wojtron2/HW_STM32H743_board_WFL/README.md

# HW_STM32H743_board_WFL
An STM32H743 KiCad project board
