wojtron2/HW_STM32H743_board_WFL/BOM/preBOM_stm32h743_board.txt

STM32H743
LQFP100

tu akurat dostępność słaba u różnych dostawców - jednak kluczowy element projektu
STM32H743VIT6
https://www.mouser.pl/pl/ProductDetail/STMicroelectronics/STM32H743VIT6?qs=FNcb6ahWXRw0Me5k2ZHgWw%3D%3D

jak wyżej - aktualnie słaba dostępność ale wymóg projektu

IMU Bosch BMI088
https://www.mouser.pl/pl/ProductDetail/Bosch-Sensortec/BMI088?qs=f9yNj16SXrIMFspTV6RB6Q%3D%3D

zasilanie DCDC SMPS
ultra low emi
LT8609SEV#PBF
https://www.mouser.pl/pl/ProductDetail/Analog-Devices/LT8609SEVPBF?qs=BZBei1rCqCCvvHT89A2j%2FQ%3D%3D

zasilanie LDO dla uC STM32H743
AP7361C-33E
https://www.mouser.pl/pl/ProductDetail/Diodes-Incorporated/AP7361C-33E-13?qs=X421pCAdHWeIInddOHvgmw%3D%3D

zasilanie dla IMU Bosch BMI088
-zastosowac wspolna linie zasilania z STM32H743 dodatkowo filtrowana-

dioda TVS zabezpieczajaca na wejsciu od strony baterii
SMBJ26A
https://www.tme.eu/pl/details/smbj26a-tr/diody-tvs-smd-jednokierunkowe/stmicroelectronics/

kwarc stm32h743
TSX-3225 16.0000MF18X-AC0
https://www.mouser.pl/pl/ProductDetail/Epson-Timing/TSX-3225-16.0000MF18X-AC0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

kond kwarca 10pF
https://www.tme.eu/pl/details/grm1555c1h100ga01d/kondensatory-mlcc-smd/murata/

bezpiecznik 1A
https://www.tme.eu/pl/details/0680l1000-05/bezpieczniki-smd-2410-zwloczne/bel-fuse/

ferryt dla vdda i BMI088
BLM21PG221SN1D
https://www.tme.eu/pl/details/blm21pg221sn1d/ferryty-koraliki/murata/

flash
W25Q512JVEIQ
https://www.mouser.pl/pl/ProductDetail/Winbond/W25Q512JVEIQ-TR?qs=l7cgNqFNU1jq8%252B28uQ9f7A%3D%3D

10pF 0402

10nF 0402 X7R
https://www.mouser.pl/pl/ProductDetail/Vishay-Vitramon/VJ0402Y103KXQCW1BC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

100nF 0402 X7R
https://www.mouser.pl/pl/ProductDetail/TAIYO-YUDEN/MSAST105SB7104MFNB25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

1uF 0603
https://www.mouser.pl/pl/ProductDetail/Walsin/SH18B105K160CT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

2.2uF 0603
https://www.mouser.pl/pl/ProductDetail/Murata-Electronics/GRM188Z71E225KE43D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

4.7uF 0603
https://www.mouser.pl/pl/ProductDetail/Samsung-Electro-Mechanics/CL10A475KO8NNNC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

47uF 1206
https://www.mouser.pl/pl/ProductDetail/TDK/C3216X5R1C476M160AB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

10k rez 0402

18.2k rez 0402

100k rez 0402

182k rez 0402

1M rez 0402

L1 2.2uH
TDK SPM3020T-2R2M-LR
https://www.mouser.pl/pl/ProductDetail/TDK/SPM3020T-2R2M-LR?qs=P8zzrVhehatRwwTBeABiag%3D%3D

EW mniejszy
TDK VLS252012HBX-2R2M-1

//////////////
zzzzzz old

LDL1117S33R
https://www.mouser.pl/pl/ProductDetail/STMicroelectronics/LDL1117S33R?qs=AQlKX63v8Rt9Bf6AWSrbFg%3D%3D

AP7361C-33E
https://www.mouser.pl/pl/ProductDetail/Diodes-Incorporated/AP7361C-33E-13?qs=X421pCAdHWeIInddOHvgmw%3D%3D

zold kwarc 16mhz
ABM10W-16.0000MHZ-6-D1X-T3
https://www.mouser.pl/pl/ProductDetail/ABRACON/ABM10W-16.0000MHZ-6-D1X-T3?qs=5aG0NVq1C4yLnsl6cawI1Q%3D%3D

/////
kwarc stm32h743
ABM3-8.000MHZ-D2Y-T
https://www.mouser.pl/pl/ProductDetail/ABRACON/ABM3-8.000MHZ-D2Y-T?qs=ihRgKfnEsN4giUXjc3yS1g%3D%3D

kond kwarca 27pF
https://www.mouser.pl/pl/ProductDetail/KYOCERA-AVX/04023U270JAT2A?qs=%252BdQmOuGyFcGHQXol69SFgA%3D%3D
