wojtron2/HW_STM32H743_board_WFL/2_STM32H743+IMU+DCDC_DRONE_CONTROL_BOARD_4L+sch.pdf

STM32H743 Drone Controller Board

This board was designed including component selection, schematic capture and PCB layout during one weekend.

The board is based on the STM32H743VIT6 and contains a DC/DC power supply based on the LT8609SEV#PBF ultralow-EMI SMPS, with optimized component placement, short high-current paths and a minimized switching hot loop to improve EMC performance, reduce parasitic inductance and maintain high power efficiency.

It also contains a W25Q512JVEIQ Flash memory with short high-speed routing, and a Bosch BMI088 IMU for inertial sensing using an integrated accelerometer and gyroscope.

The board uses a 4-layer stackup, where:
1 – TOP: signals, components, local GND copper and power routing
2 – GND PLANE: solid ground plane providing low-inductance return current paths, good signal reference and improved EMC performance
3 – POWER PLANE: low-impedance power distribution plane
4 – BOTTOM: secondary signal routing mixed with GND copper

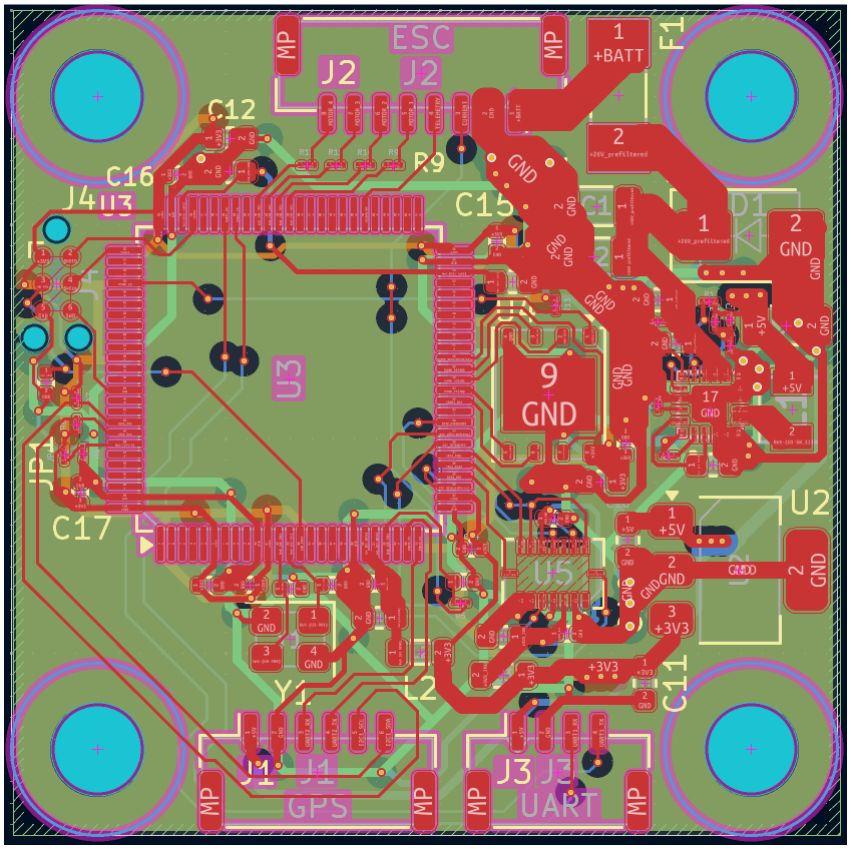
[picture p1: figure]
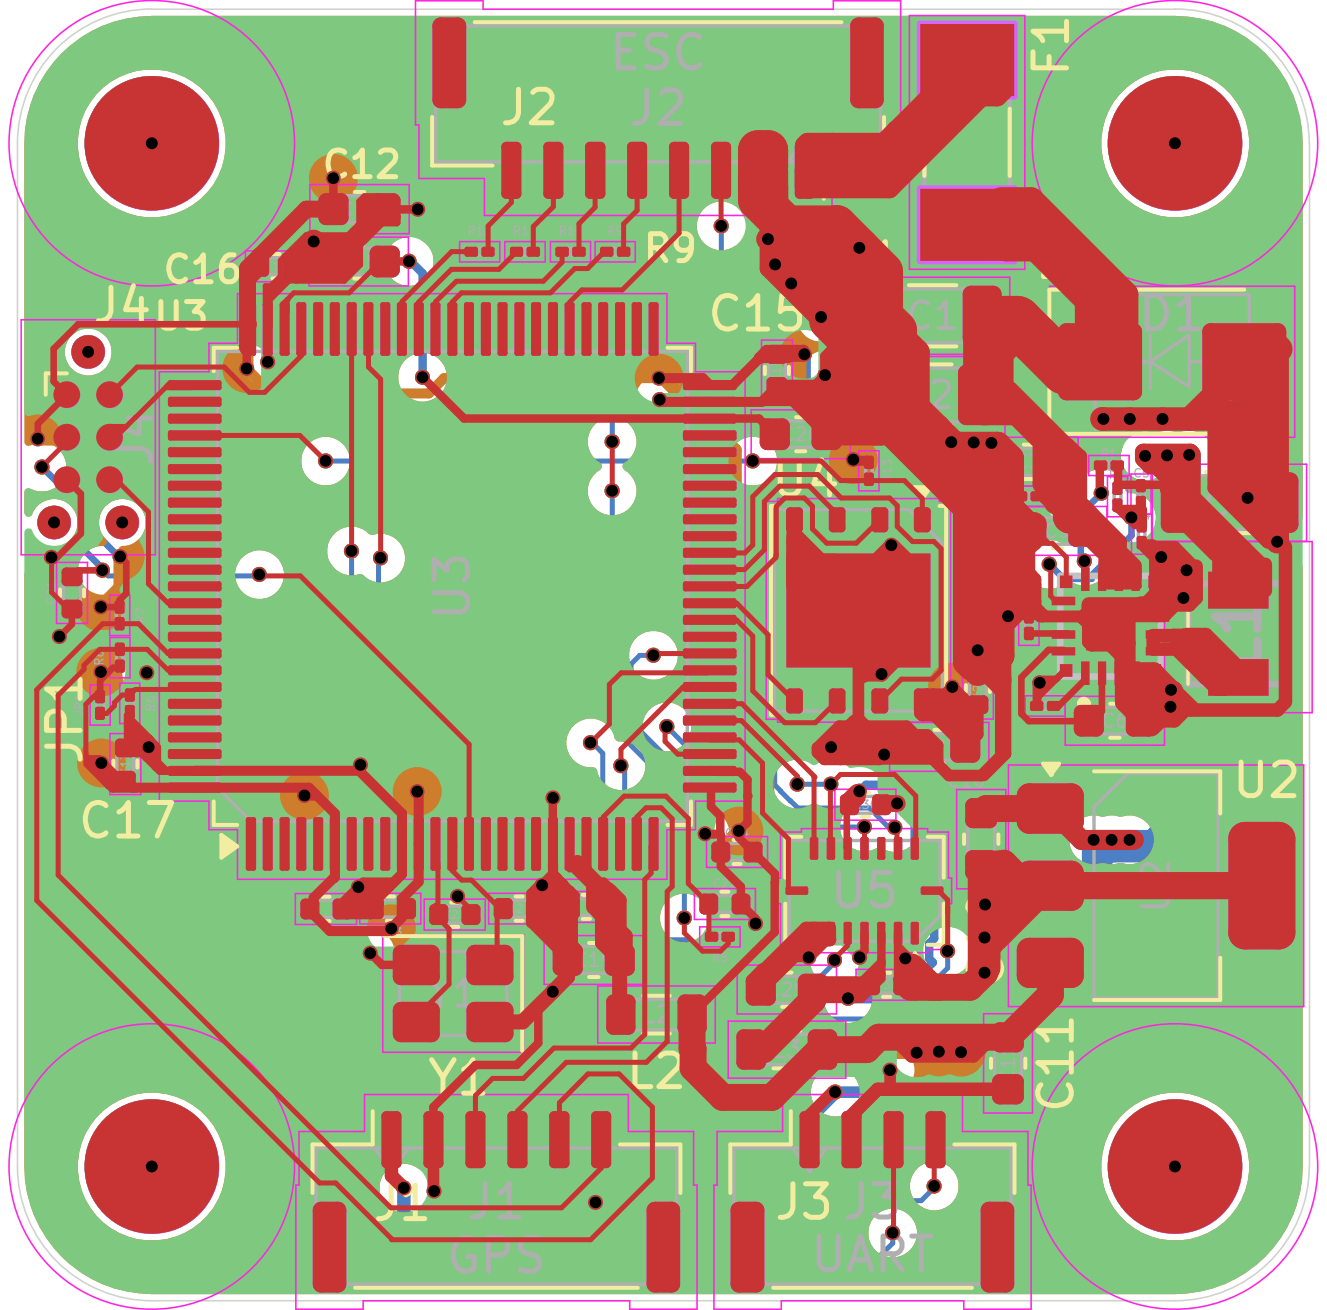
[picture p2: page 2]

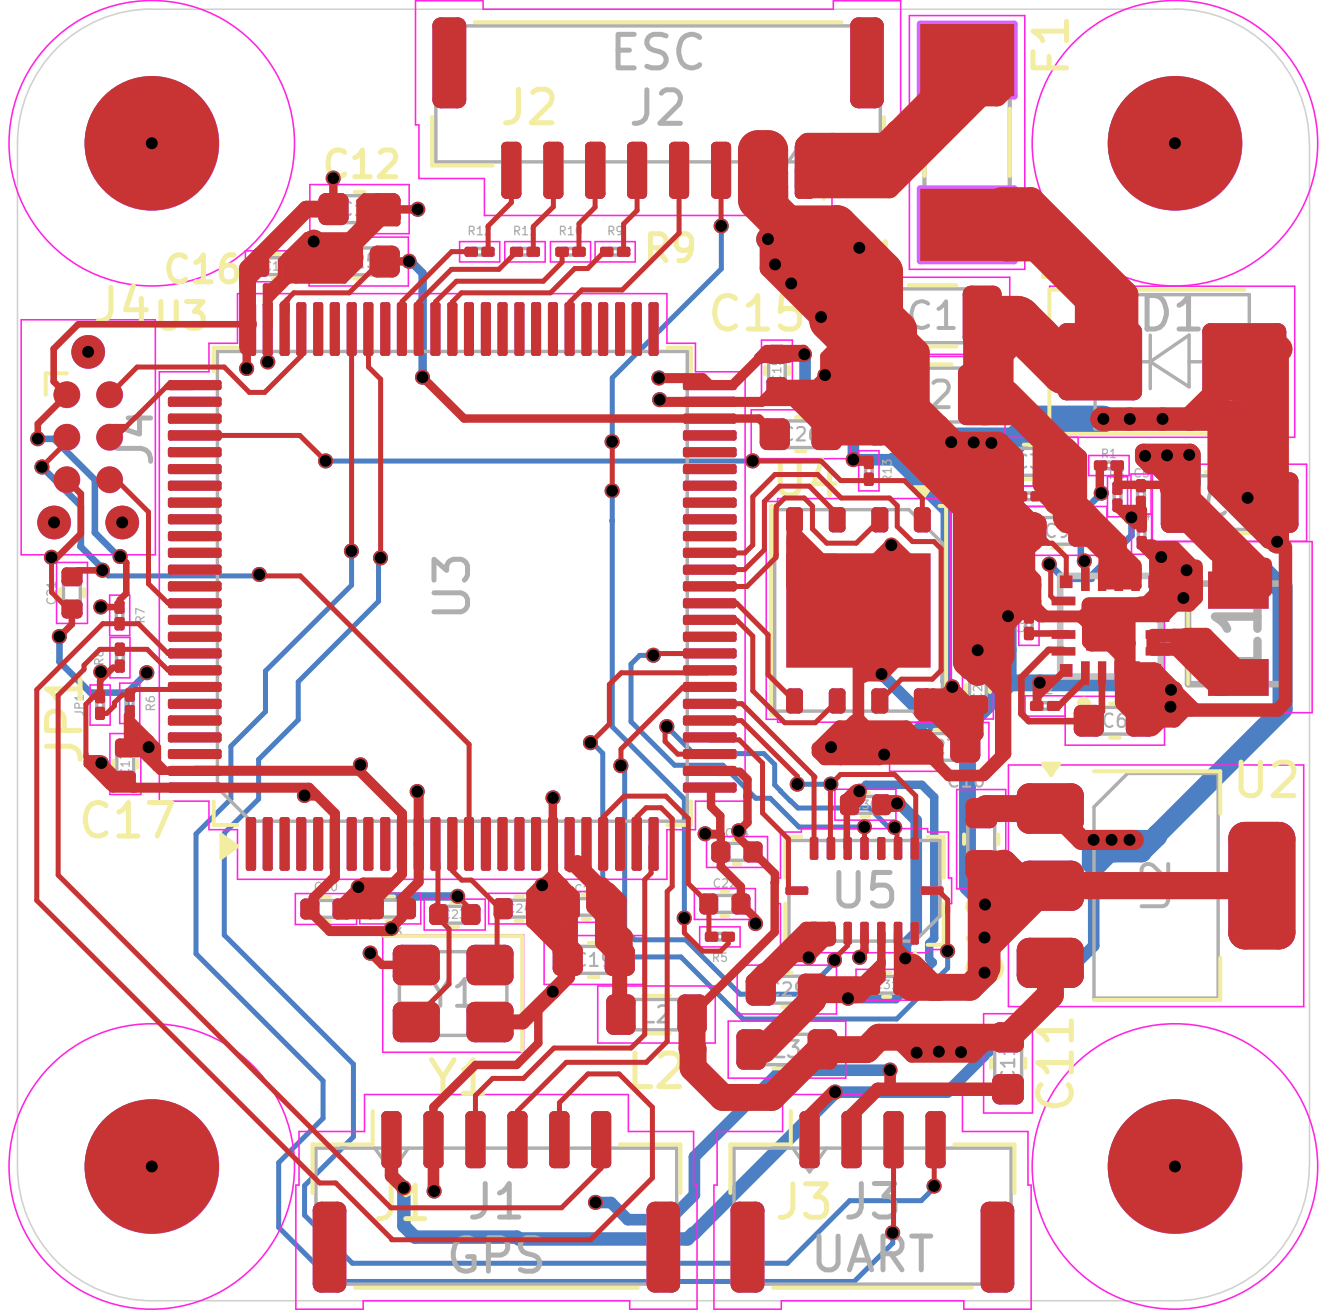
[picture p3: page 3]

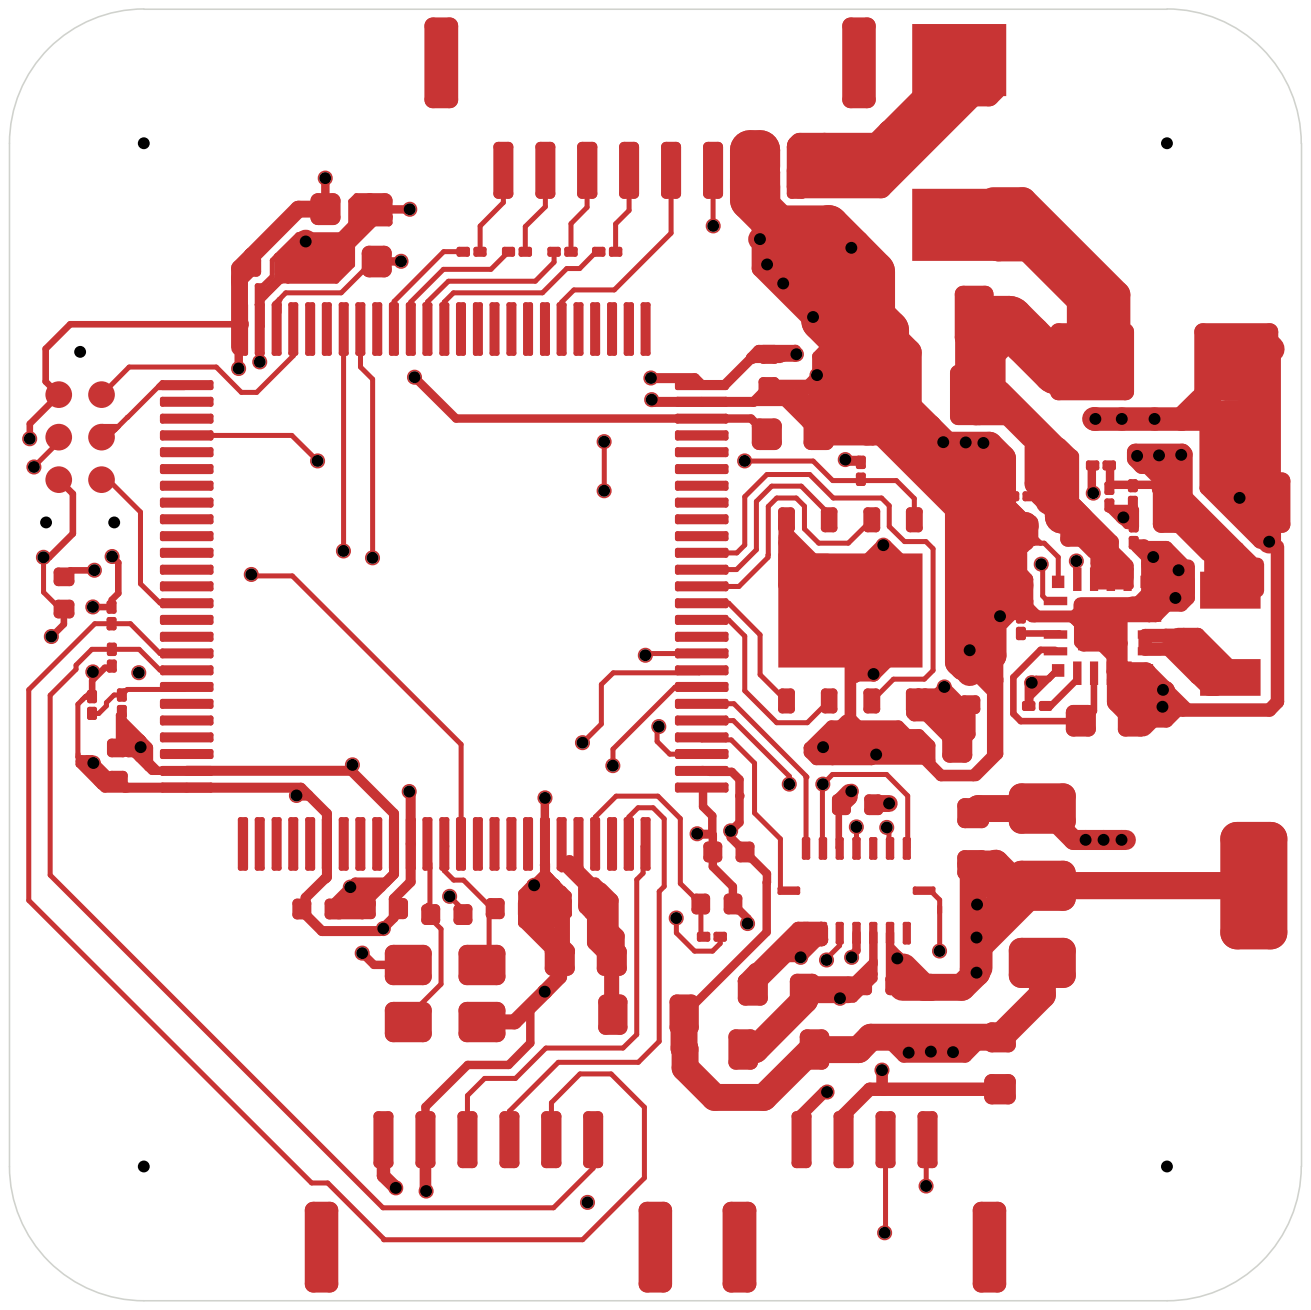
[picture p4: page 4]

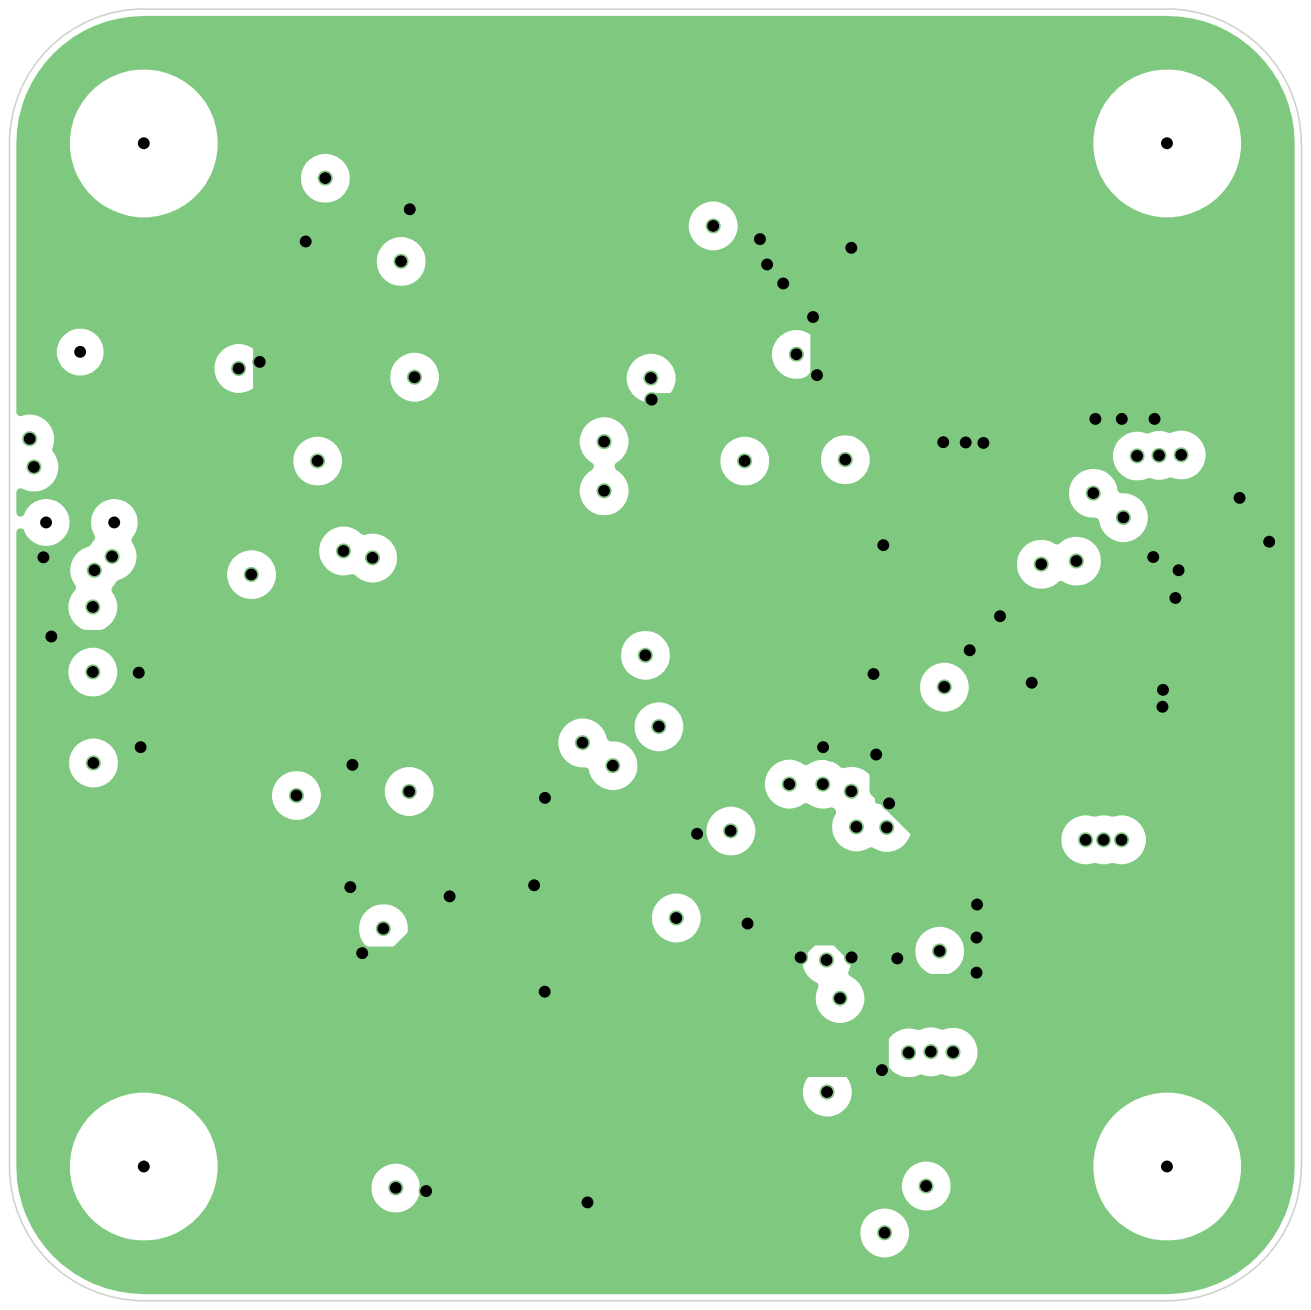
[picture p5: page 5]

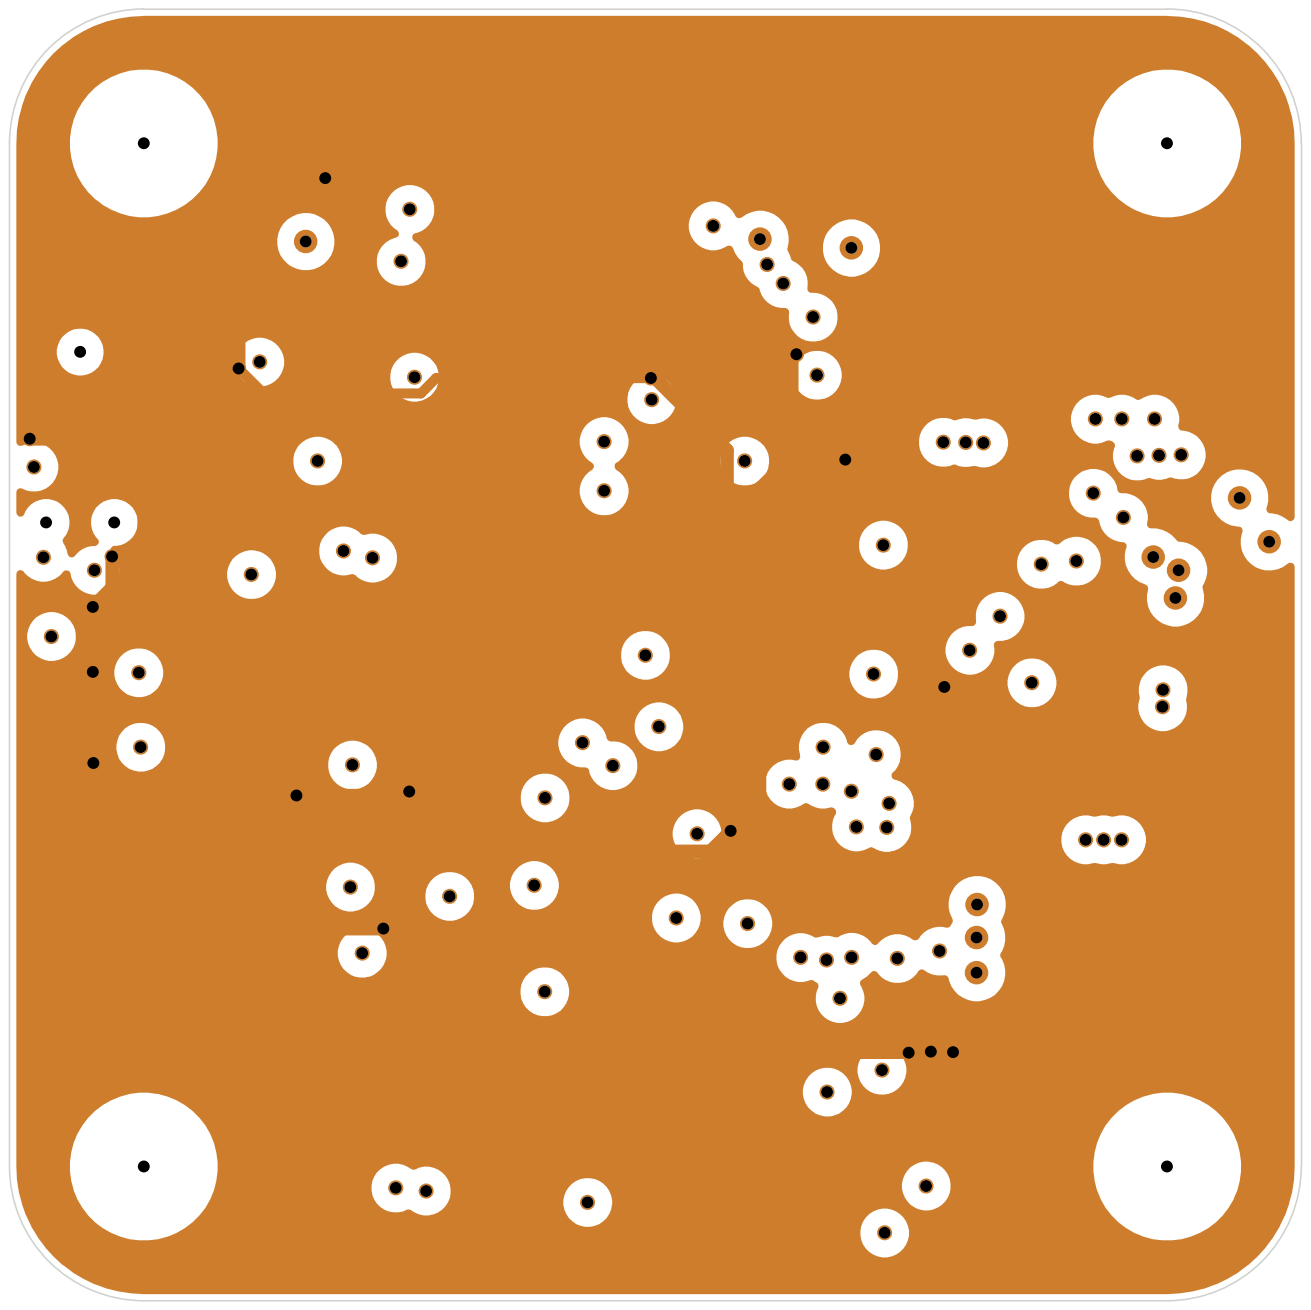
[picture p6: page 6]

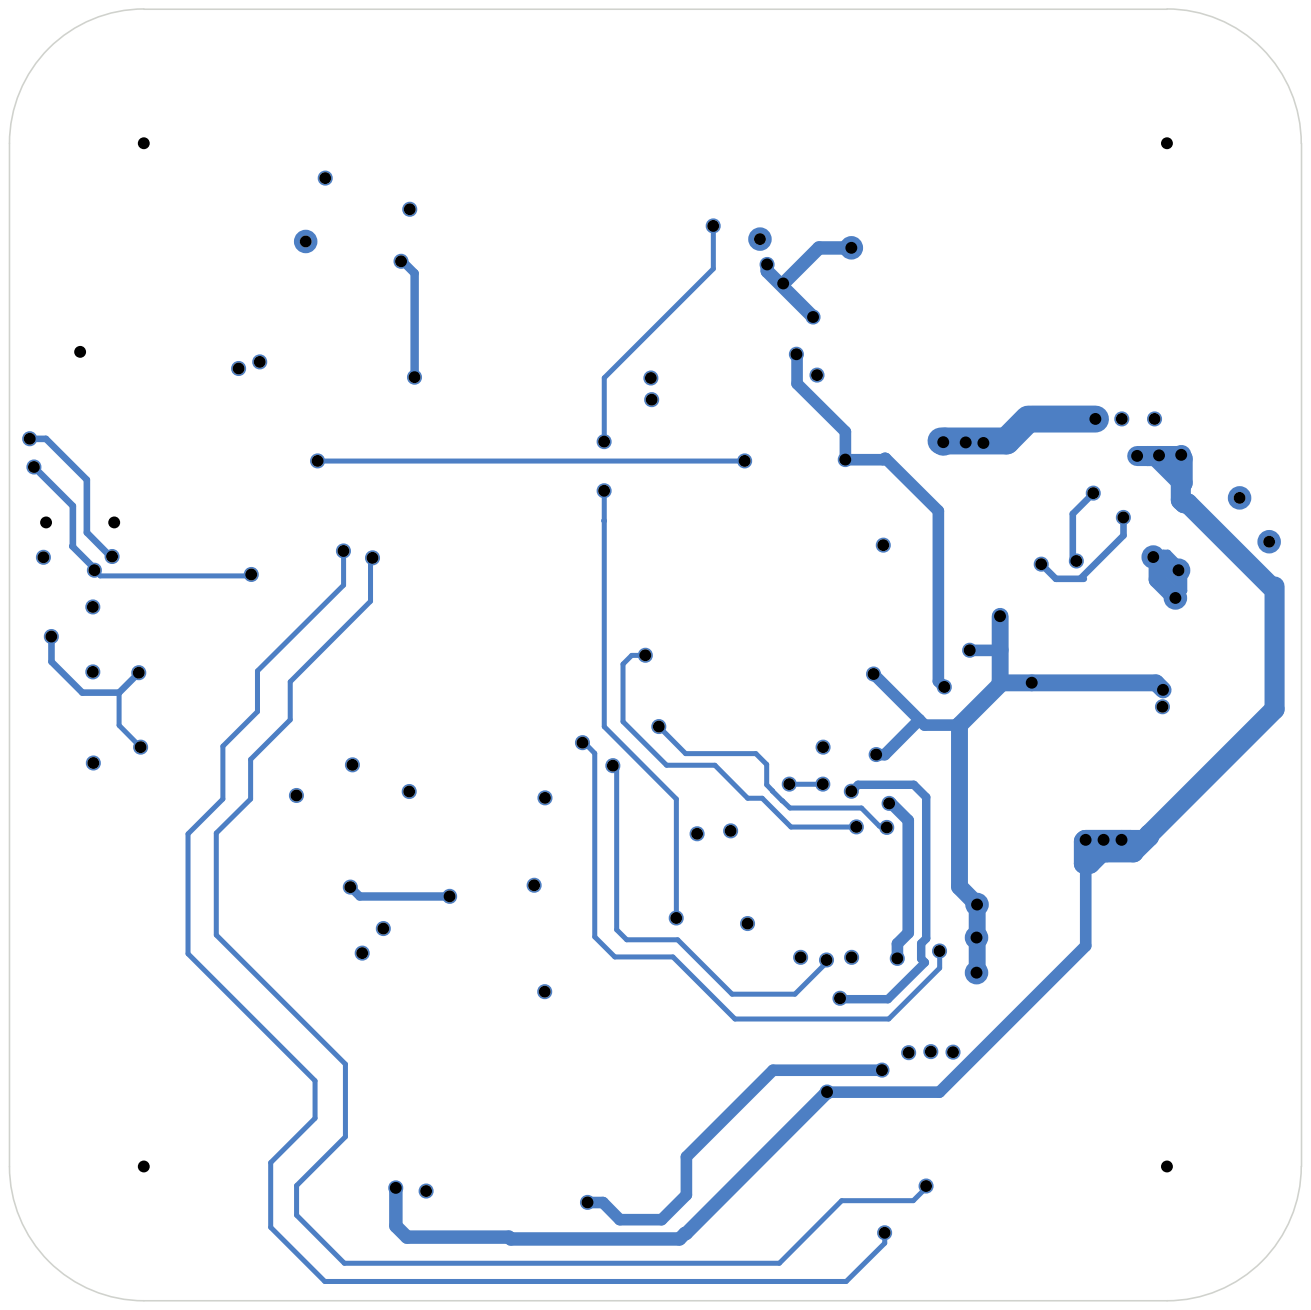
[picture p7: page 7]

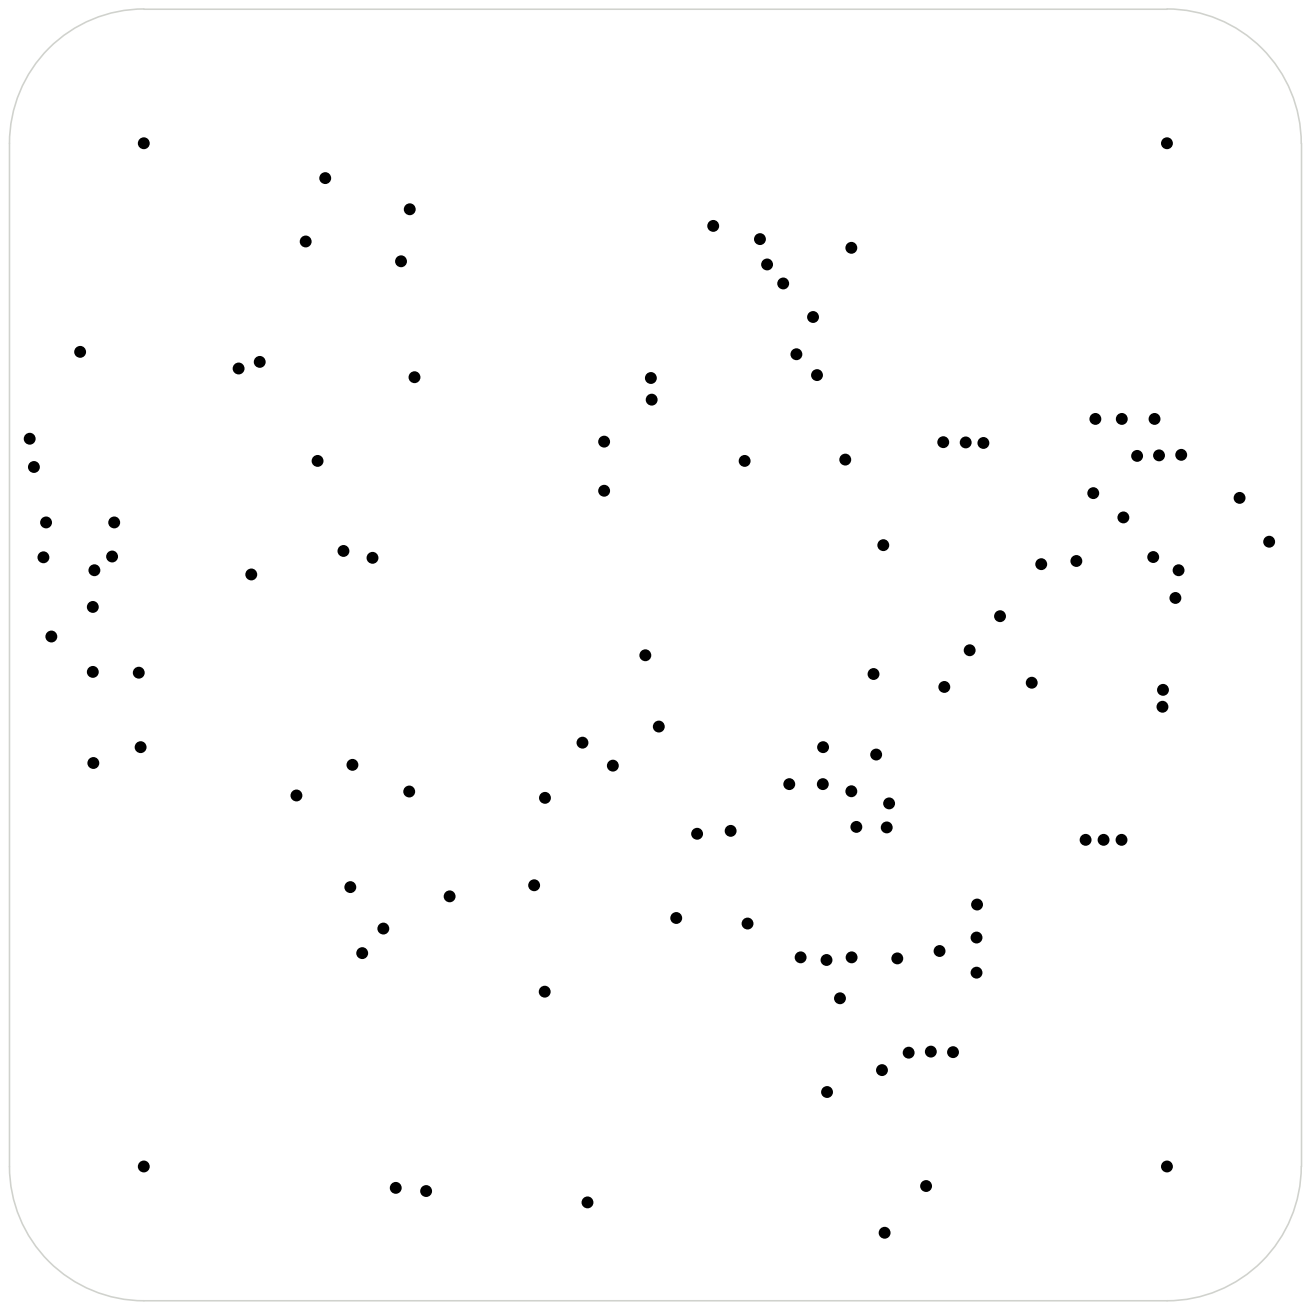
[picture p8: page 8]

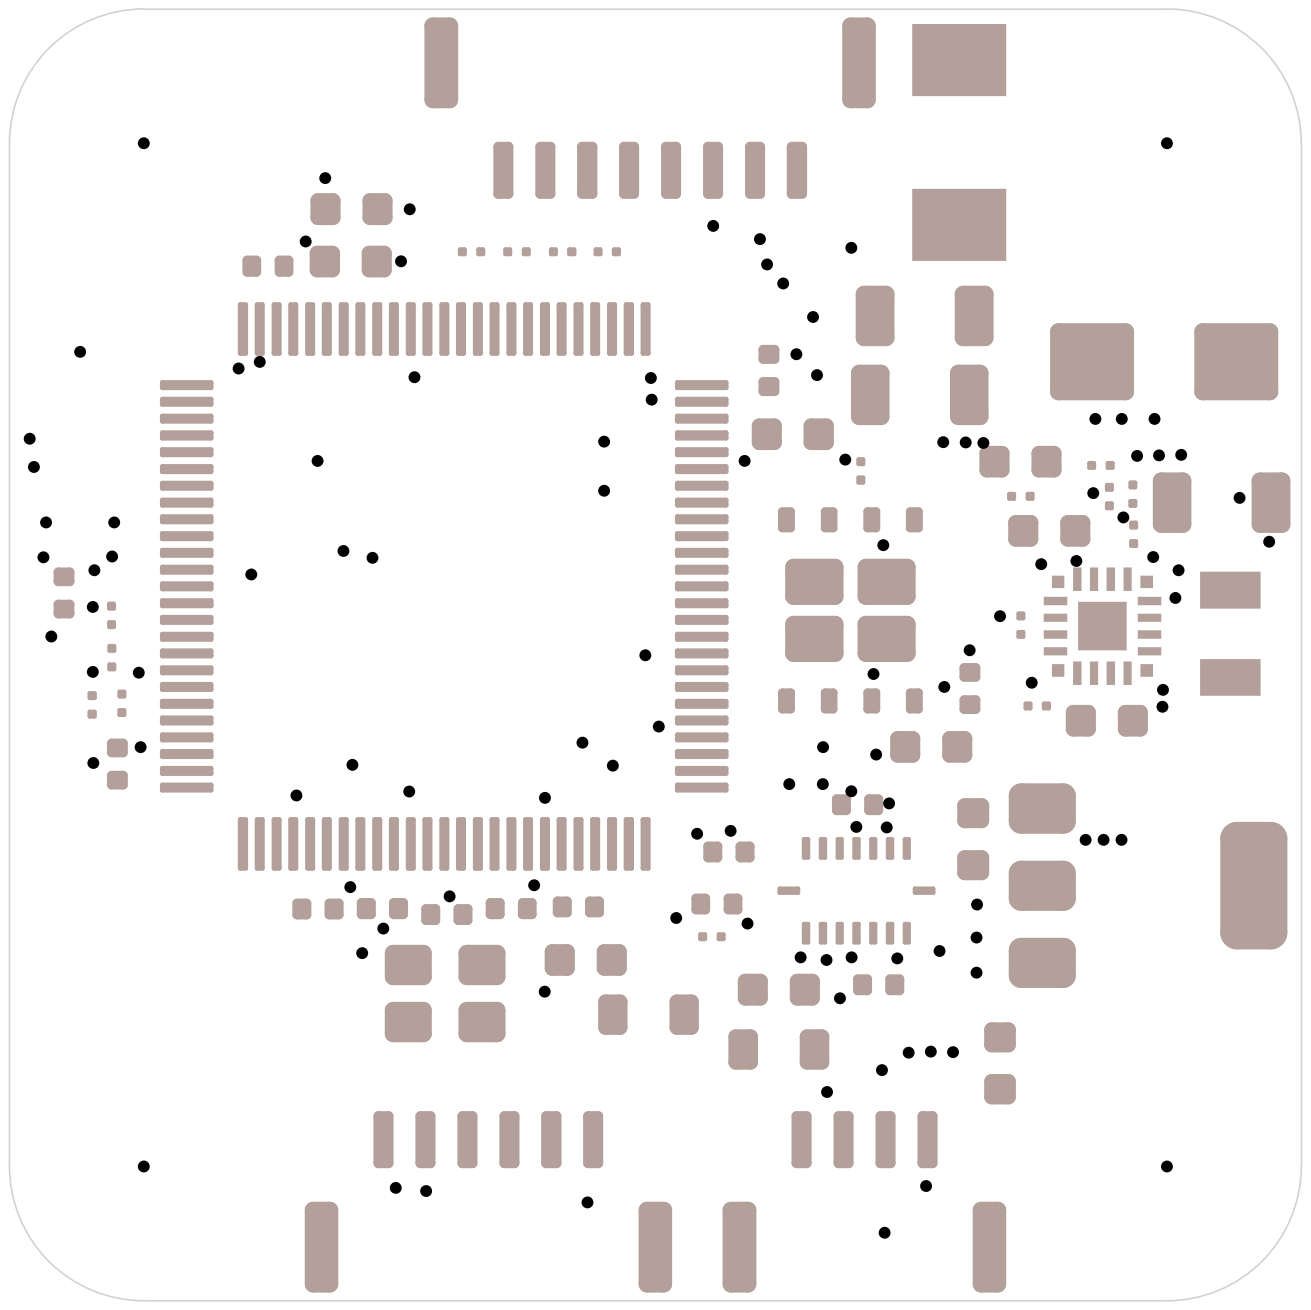
[picture p9: page 9]

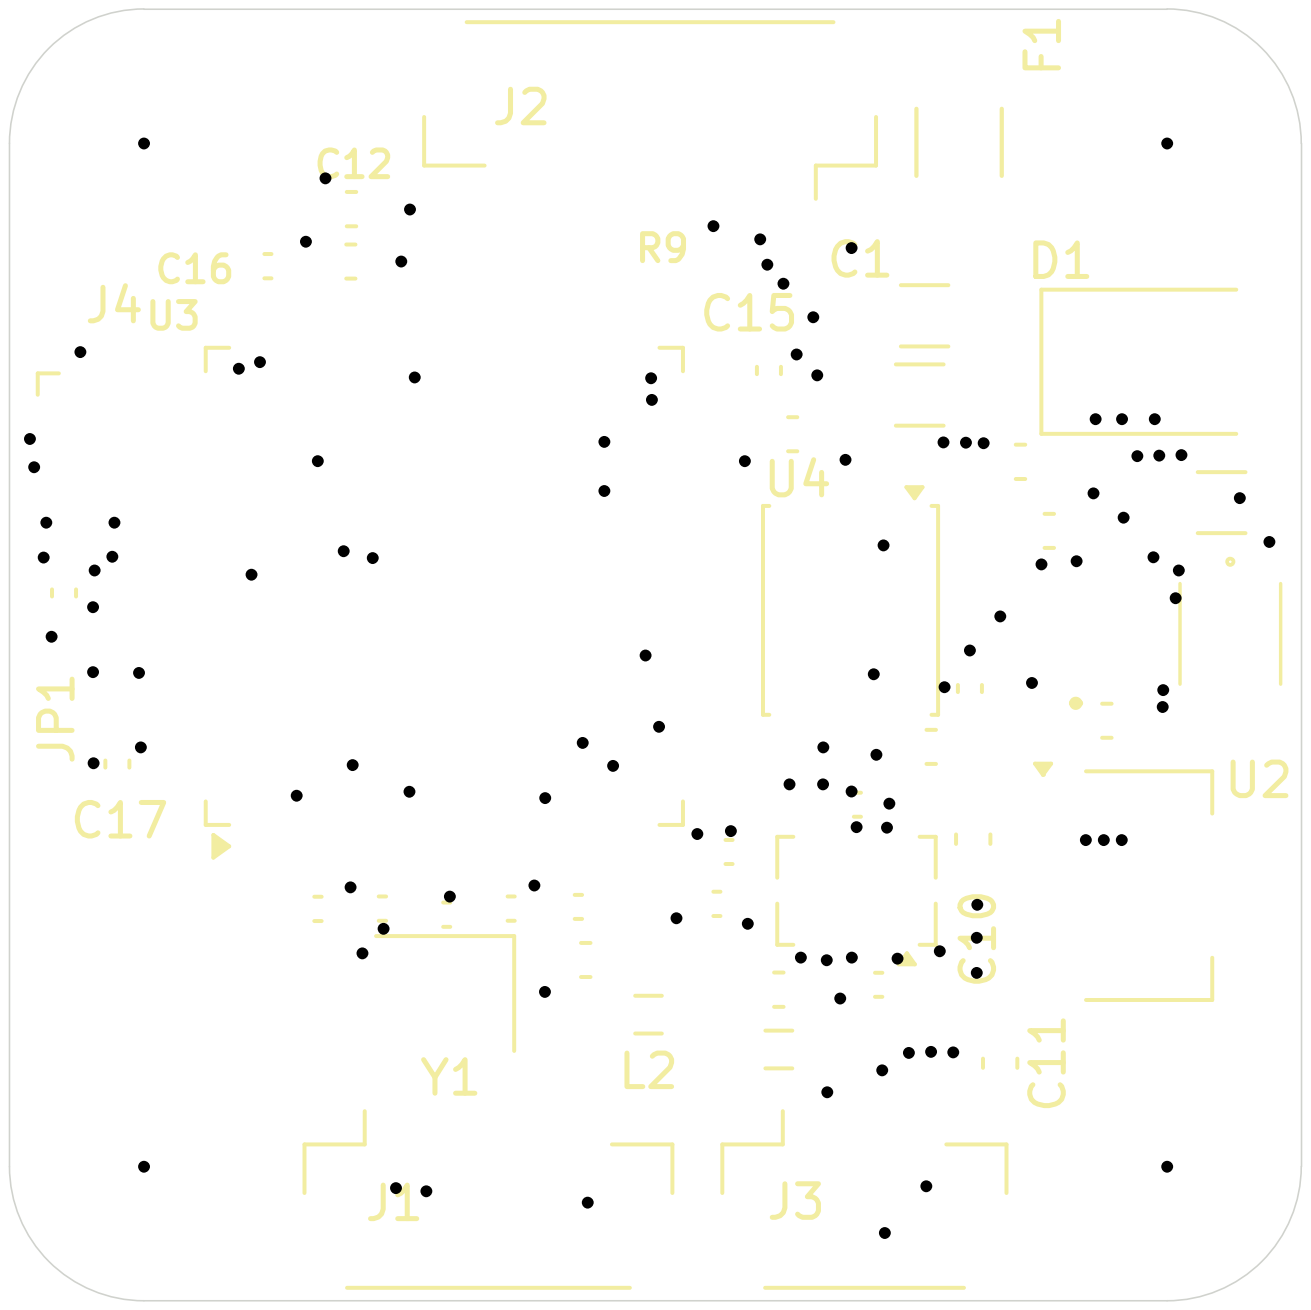
[picture p10: page 10]

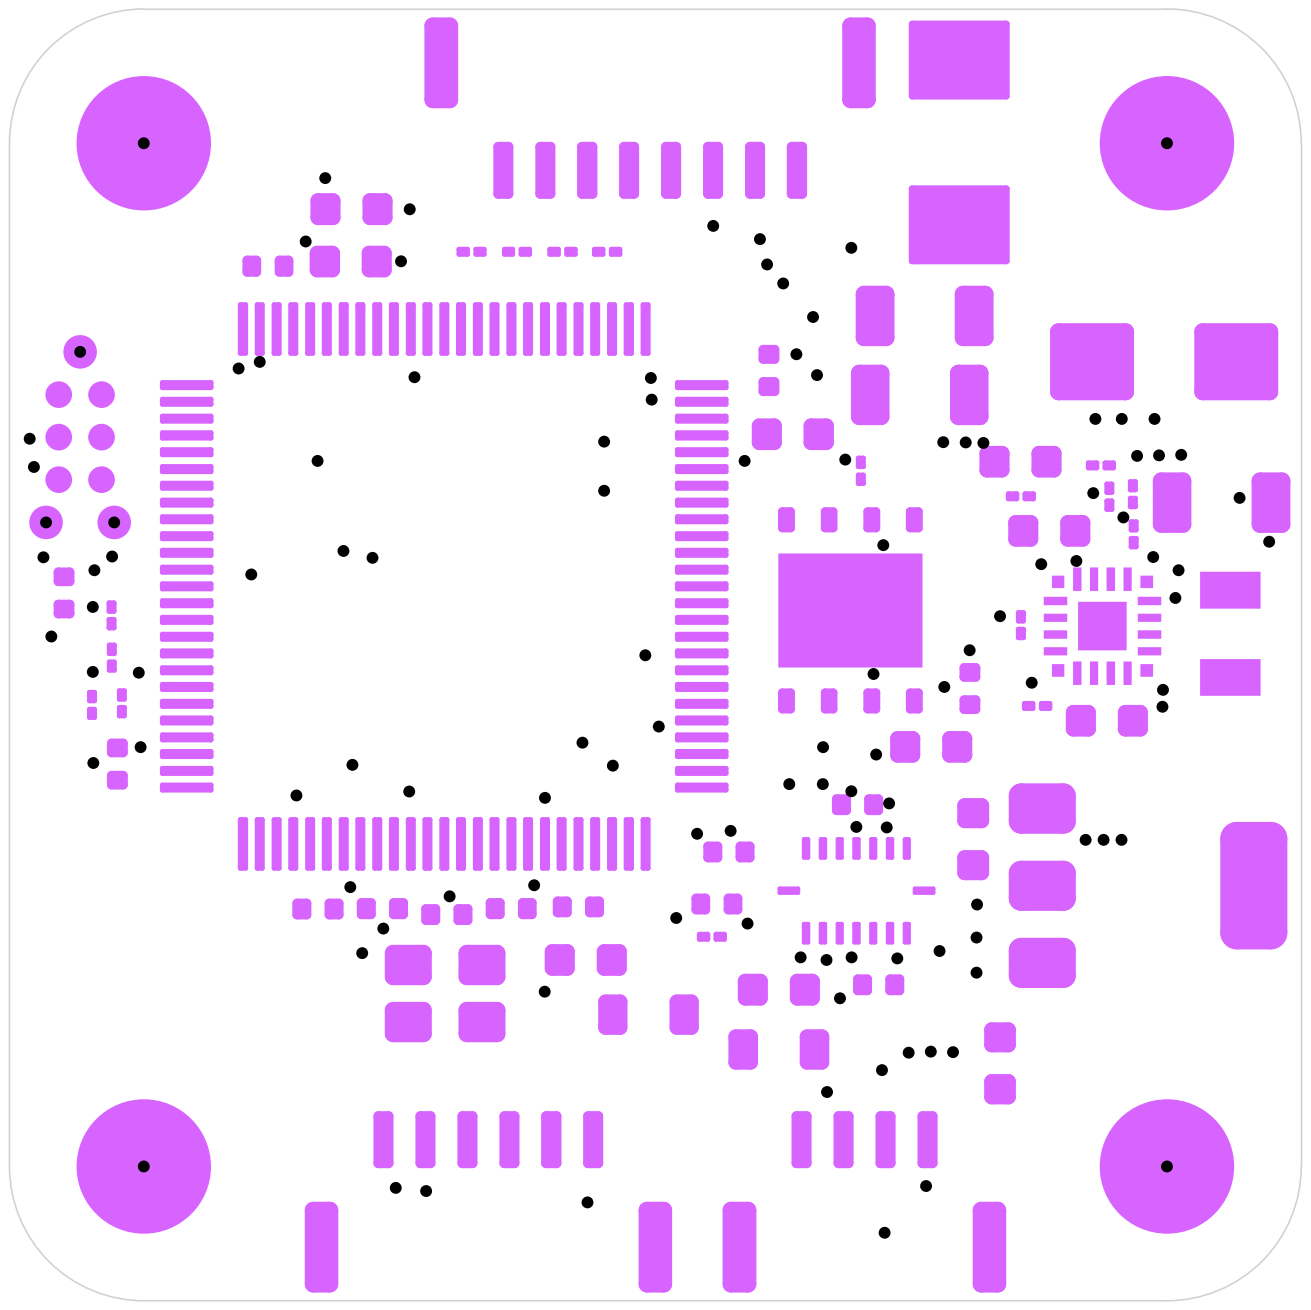
[picture p11: page 11]

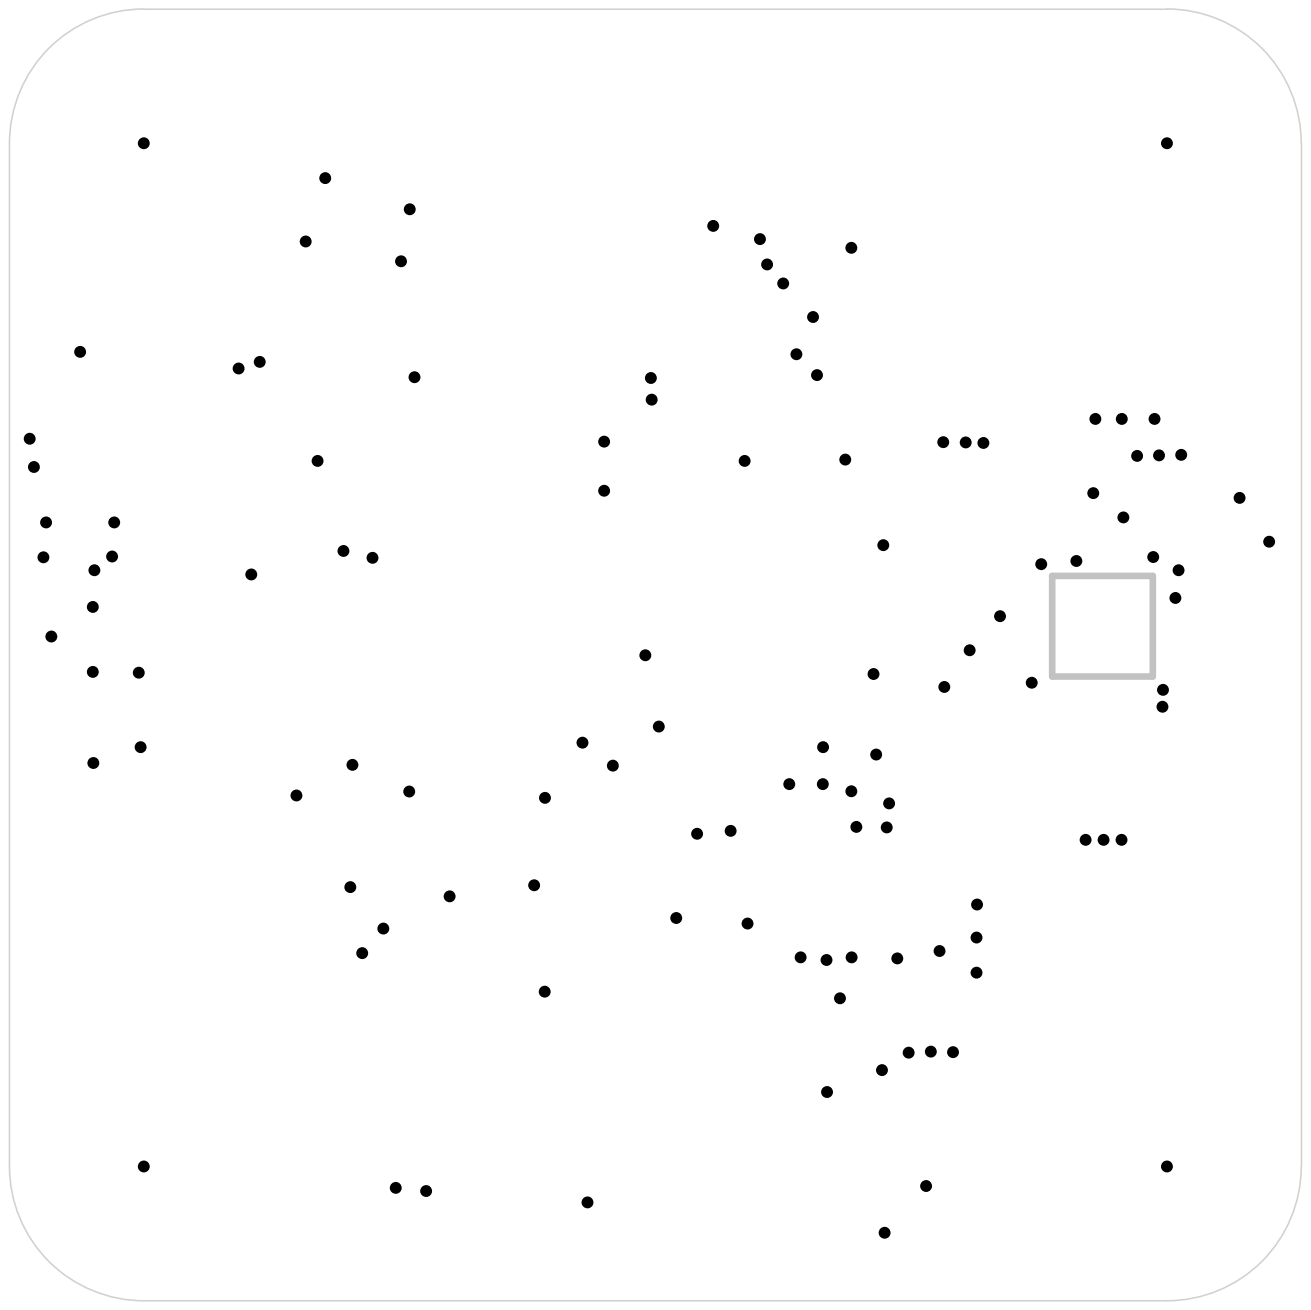
[picture p12: page 12]

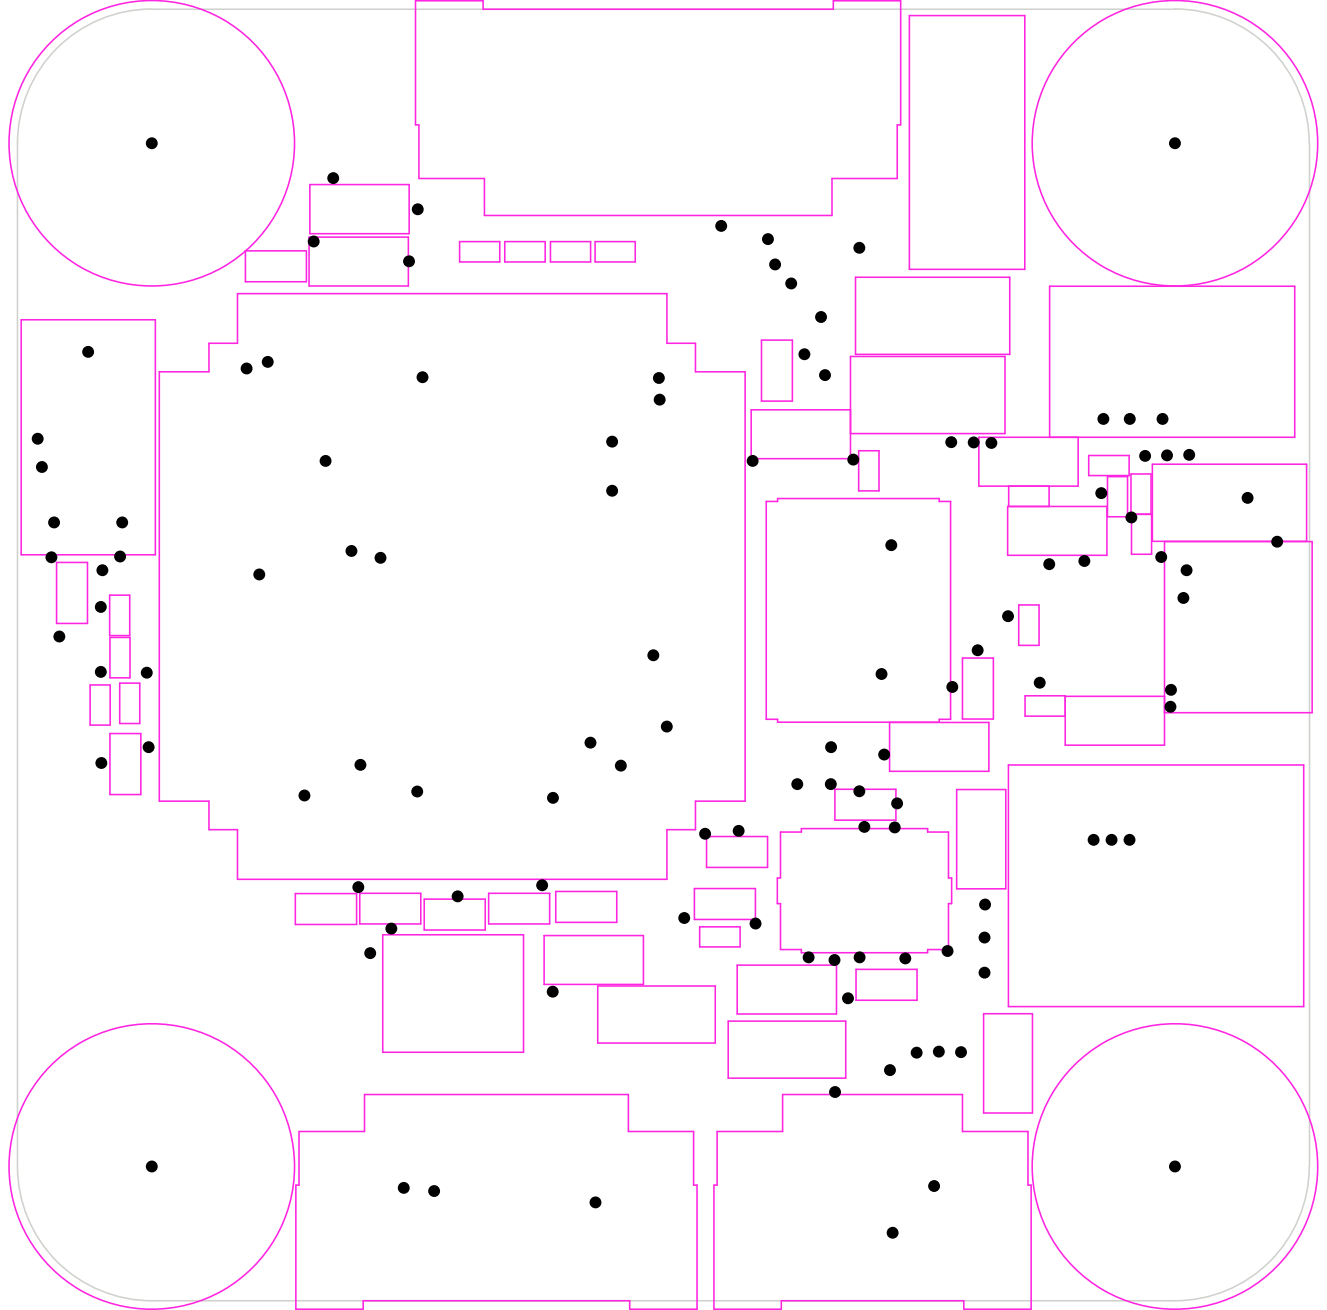
[picture p13: page 15]

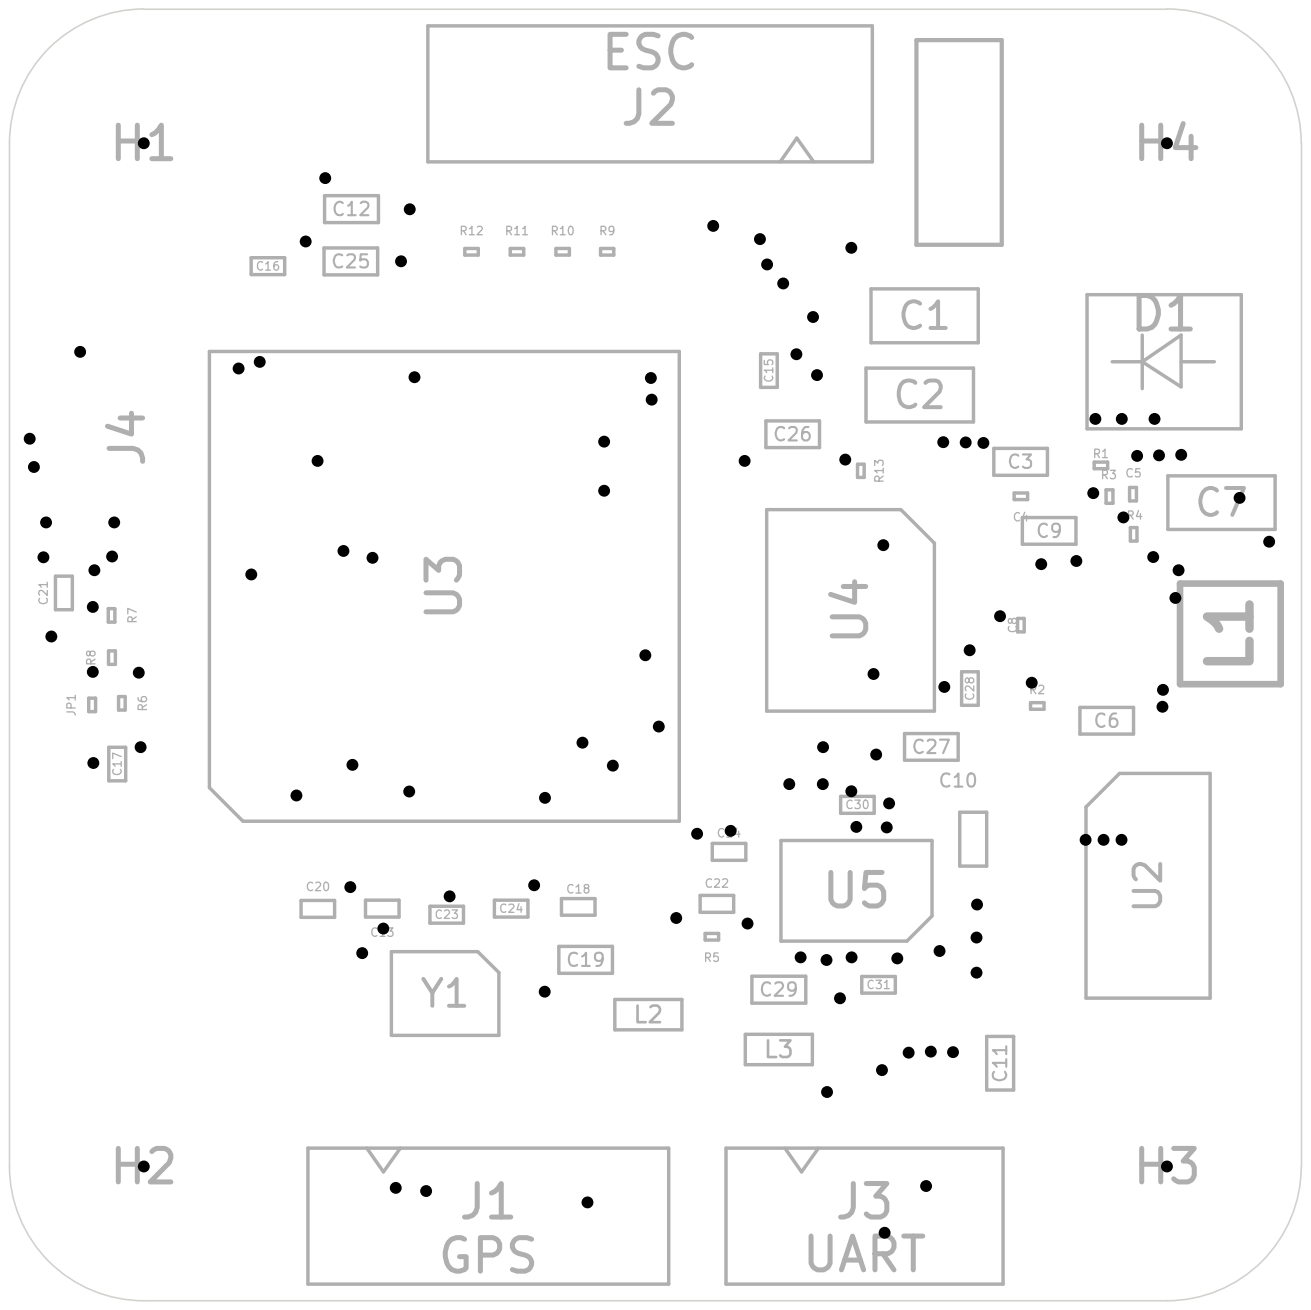
[picture p14: page 16]

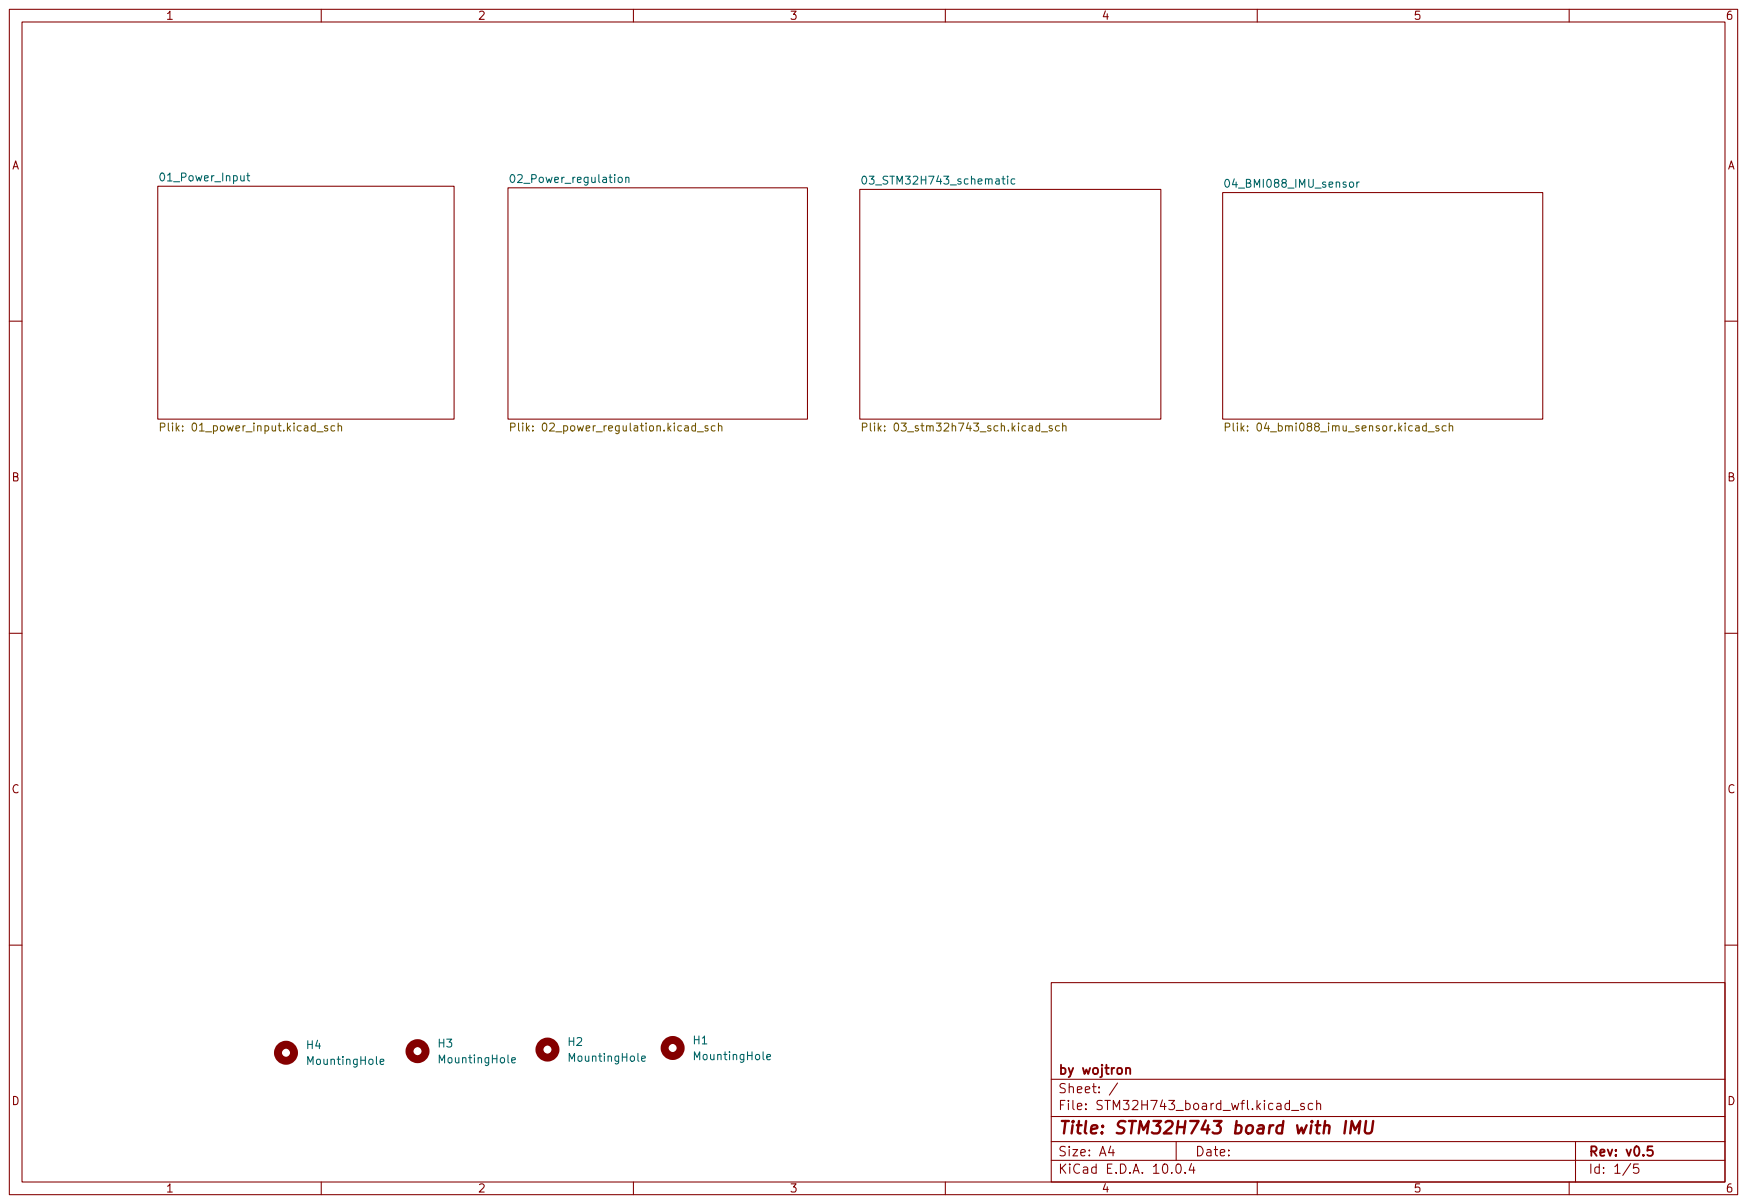
[picture p15: page 17]

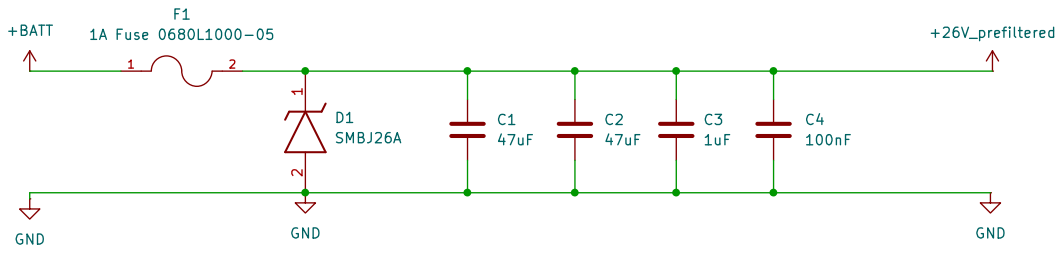
[picture p16: page 18]

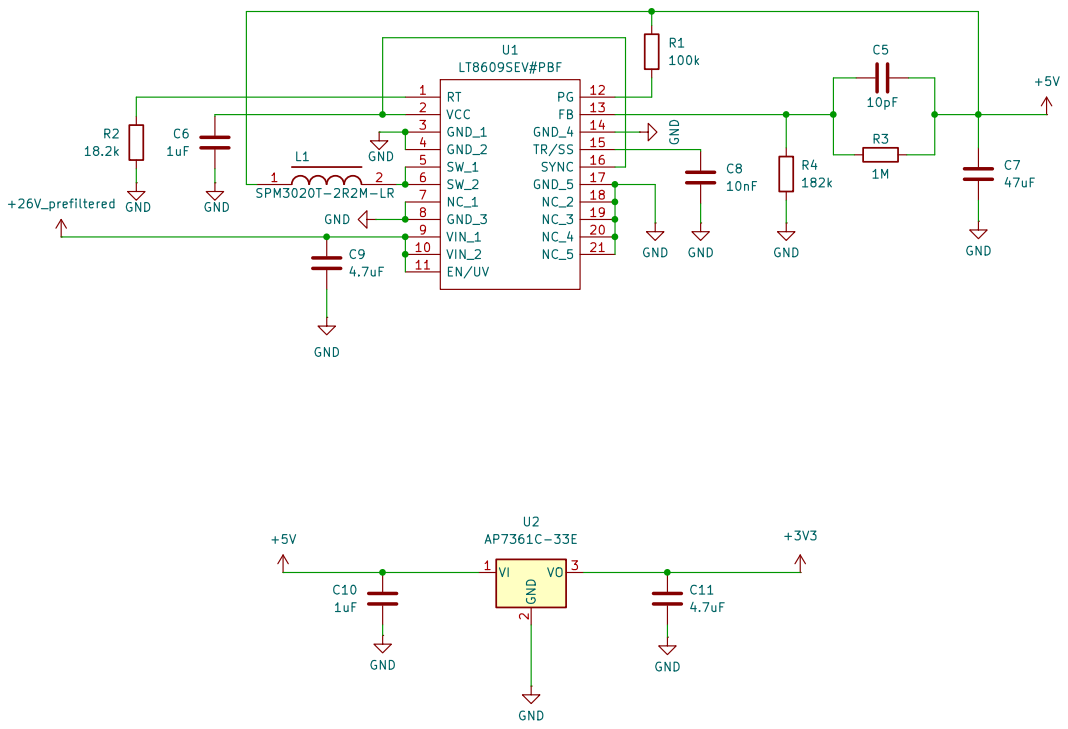
[picture p17: page 19]

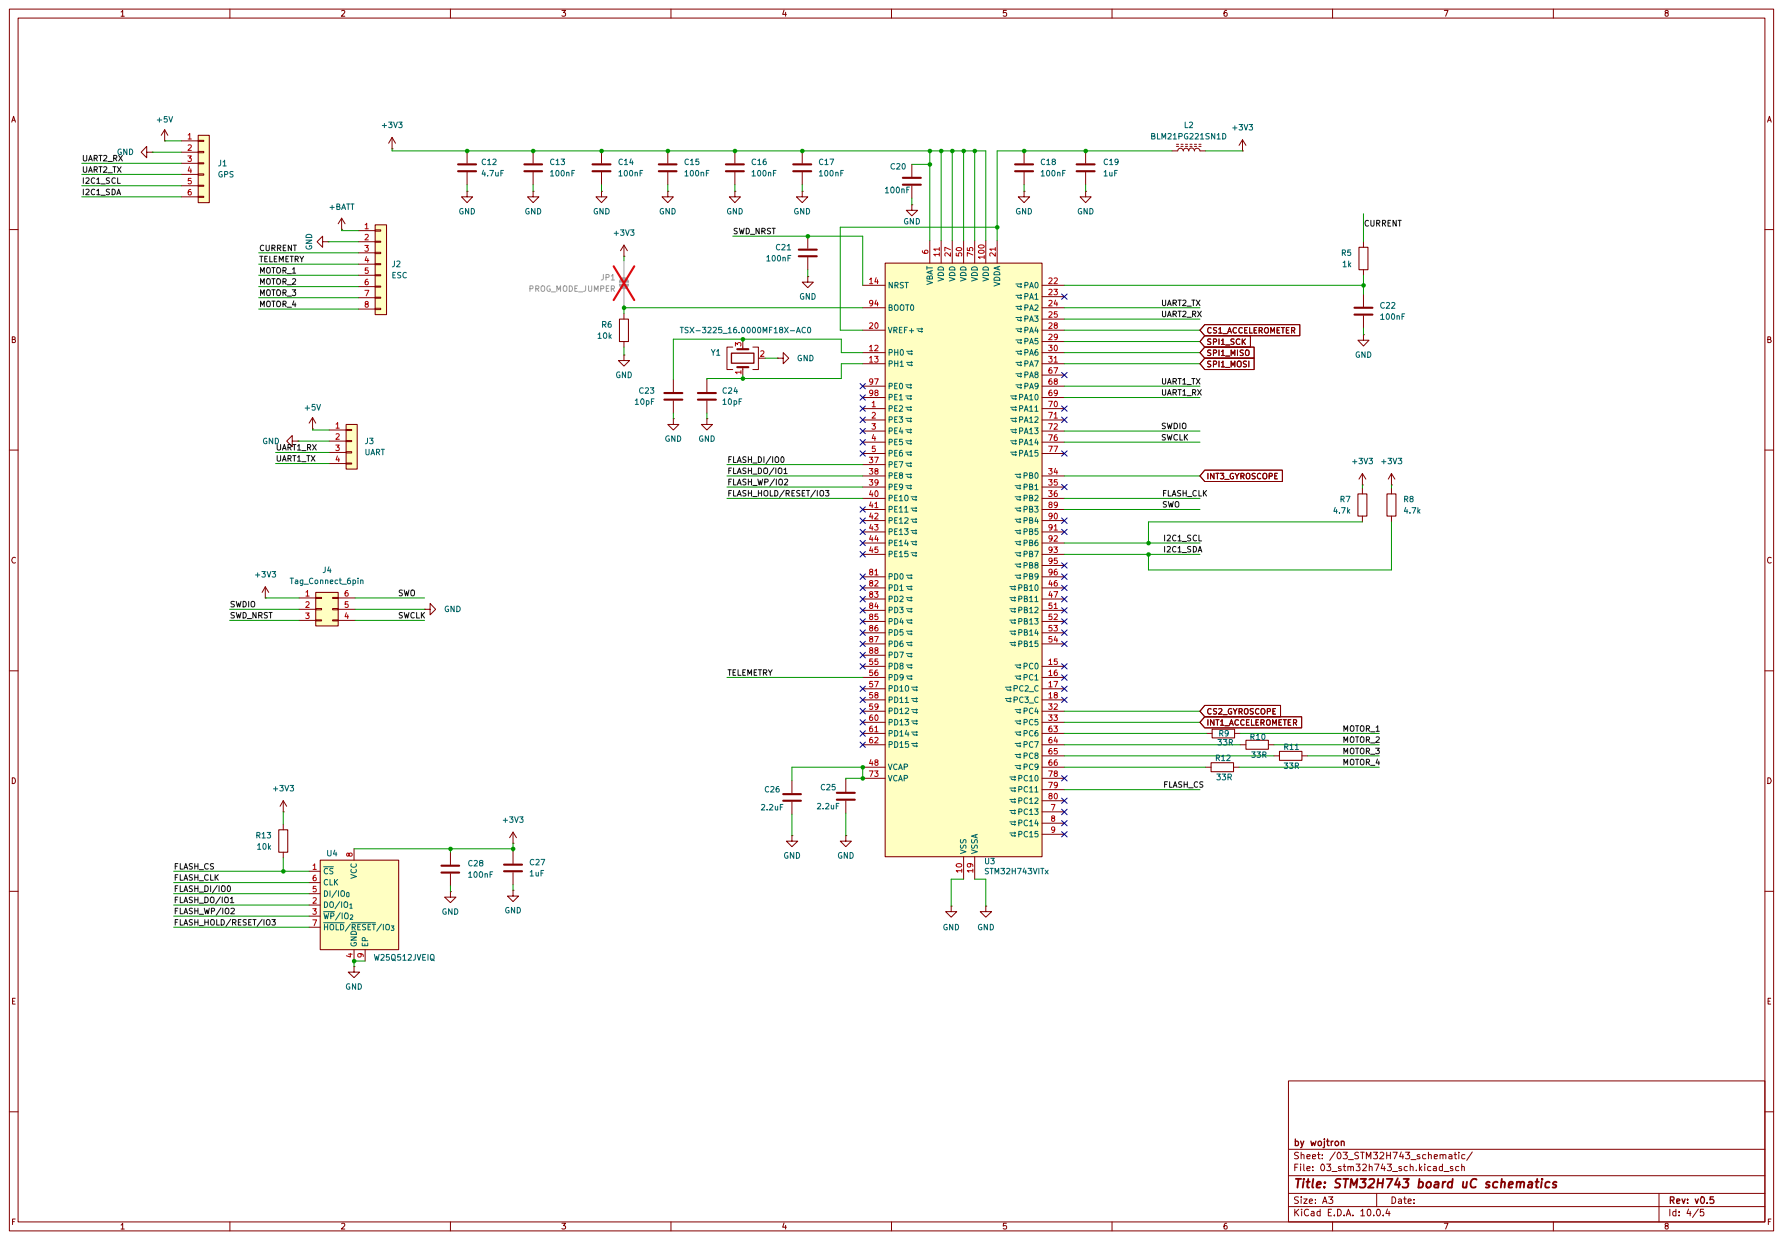
[picture p18: page 20]

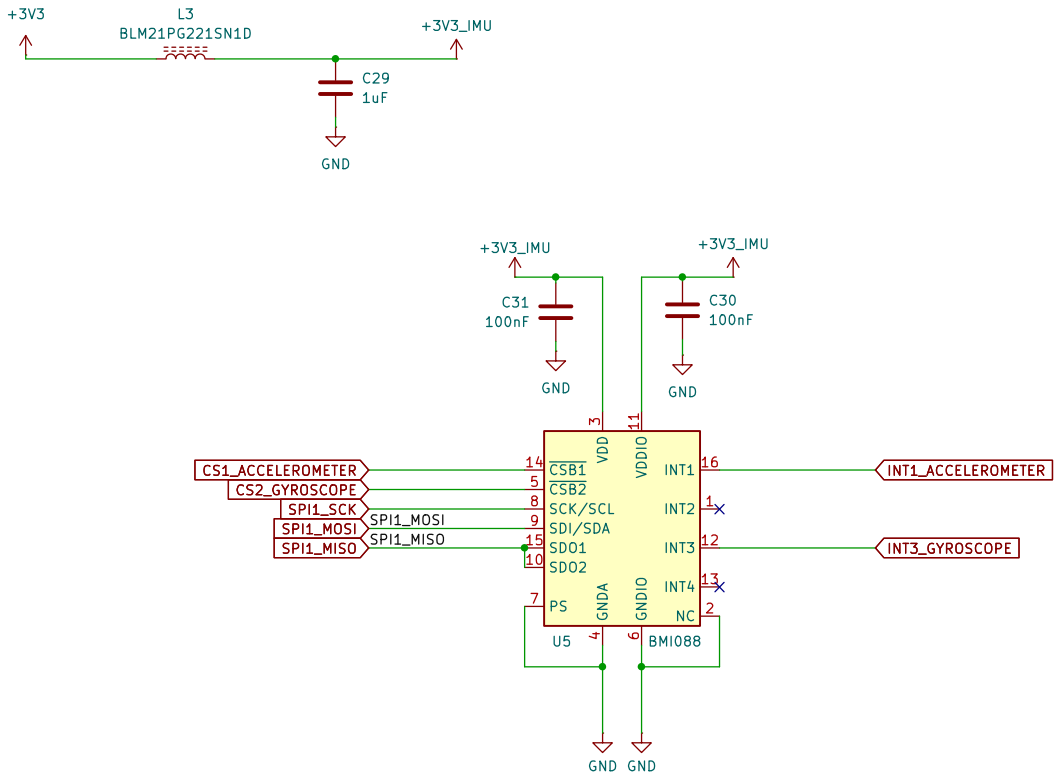
[picture p19: page 21]
