wojtron2/HW_STM32H743_board_WFL/(commit log)

2026-08-28 init + bom
2026-08-28 board init
    [STM32H743_board_wfl.kicad_pcb, STM32H743_board_wfl.kicad_sch]
2026-08-28 update bibliotek footprintow
2026-08-28 schematic filenames update
    [01_power_input.kicad_sch, 02_power_regulation.kicad_sch, 03_stm32h743_sch.kicad_sch, 04_bmi088_imu_sensor.kicad_sch, STM32H743_board_wfl.kicad_sch, power_input.kicad_sch, power_regulation.kicad_sch, stm32h743_sch.kicad_sch]
2026-08-28 v0.3 uzupelniony prebom + placement BMI088 na sch
    [02_power_regulation.kicad_sch, 03_stm32h743_sch.kicad_sch, 04_bmi088_imu_sensor.kicad_sch]
2026-08-29 v0.4 poprawki inputa zasilania
    [01_power_input.kicad_sch]
2026-08-29 v0.4b power smps
    [02_power_regulation.kicad_sch]
2026-08-29 v0.4c stm
    [03_stm32h743_sch.kicad_sch]
2026-08-29 v.04d IMU
    [03_stm32h743_sch.kicad_sch, 04_bmi088_imu_sensor.kicad_sch]
2026-08-29 v0.5 schematics + lib update
    [01_power_input.kicad_sch, 02_power_regulation.kicad_sch, 03_stm32h743_sch.kicad_sch, 04_bmi088_imu_sensor.kicad_sch, STM32H743_board_wfl.kicad_sch]
2026-08-29 v0.5b tvs and stm32 vbat fixes
    [01_power_input.kicad_sch, 02_power_regulation.kicad_sch, 03_stm32h743_sch.kicad_sch]
2026-08-29 PCB v0.1 - PCB dimensions, holes, design rules
    [STM32H743_board_wfl.kicad_pcb]
2026-08-29 v0.5 footprint and lib fixes LT8609
    [02_power_regulation.kicad_sch, 03_stm32h743_sch.kicad_sch]
2026-08-29 PCB v0.1b connectors
    [01_power_input.kicad_sch, STM32H743_board_wfl.kicad_pcb, STM32H743_board_wfl.kicad_sch]
2026-08-29 PCB v0.1c components grouping
    [STM32H743_board_wfl.kicad_pcb]
2026-08-29 PCB v0.1d components placement STM32 caps
    [01_power_input.kicad_sch, 03_stm32h743_sch.kicad_sch, STM32H743_board_wfl.kicad_pcb, STM32H743_board_wfl.kicad_sch]
2026-08-29 SCH v0.6 LT8609 NC -> GND
    remove floats according to datasheet
    [02_power_regulation.kicad_sch]
2026-08-29 SCH v0.6b new crystal + library update
    [03_stm32h743_sch.kicad_sch]
2026-08-29 update stm32 quartz caps + prebom
    [03_stm32h743_sch.kicad_sch, STM32H743_board_wfl.kicad_pcb]
2026-08-29 PCB v0.2 STM32 components preplaced
    [STM32H743_board_wfl.kicad_pcb]
2026-08-29 PCB v0.3 placement comps
2026-08-29 LT8609 footprint cuts
    [02_power_regulation.kicad_sch, 03_stm32h743_sch.kicad_sch, STM32H743_board_wfl.kicad_pcb]
2026-08-29 PCB v0.4 components placement first phase done
    [STM32H743_board_wfl.kicad_pcb]
2026-08-29 set route and vias sizes
    [STM32H743_board_wfl.kicad_pcb]
2026-08-29 PCB v0.5 SMPS hot loop optimization + fab texts removal
    [STM32H743_board_wfl.kicad_pcb]
2026-08-29 PCB v0.6 routing part1
    [STM32H743_board_wfl.kicad_pcb]
2026-08-29 PCB v0.7 routing part2
    [STM32H743_board_wfl.kicad_pcb]
2026-08-29 PCB v0.7 routing part3
    [03_stm32h743_sch.kicad_sch, STM32H743_board_wfl.kicad_pcb]
2026-08-29 PCB v0.7 routing part4
    [STM32H743_board_wfl.kicad_pcb]
2026-08-29 PCB v0.7 routing part5
    [STM32H743_board_wfl.kicad_pcb]
2026-08-30 PCB v1
    [BOM_STM32H743_board_wfl.xlsx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]
2026-09-01 PCB v1.0
    [03_stm32h743_sch.kicad_sch]
